ProjetLUDOMAT/Prototypes/README.md

# prototype

état du 2 décembre 2023 :
La voiture prototype sans contrôle optimal ni modèle inertiel 

https://github.com/ProjetLUDOMAT/prototype/assets/90700891/5bf04b09-5f97-4a13-8e84-bf554dca9c00
