ProjetLUDOMAT/Prototypes/Gilles/Proto 4/README.md

<p align="center">
  
<p/>
  
## Introduction

Quatrieme prototype, très proche de Proto 3. Mêmes moteurs et mêmes drivers. Le microcontrolleur est un RP2040 Zero, clone chinois du Raspberry Pico à 23 broches seulement (20 GPIOs). Deux LEDs blanches ont été ajoutées à l'avant pour indiquer le sens de déplacement. La diode neopixel du RP2040 Zero est utilisée pour indiquer le mode de fonctionnement. Un algorithme de détection de la télécommande a été ajouté.

## Schéma electrique

<p align="center">
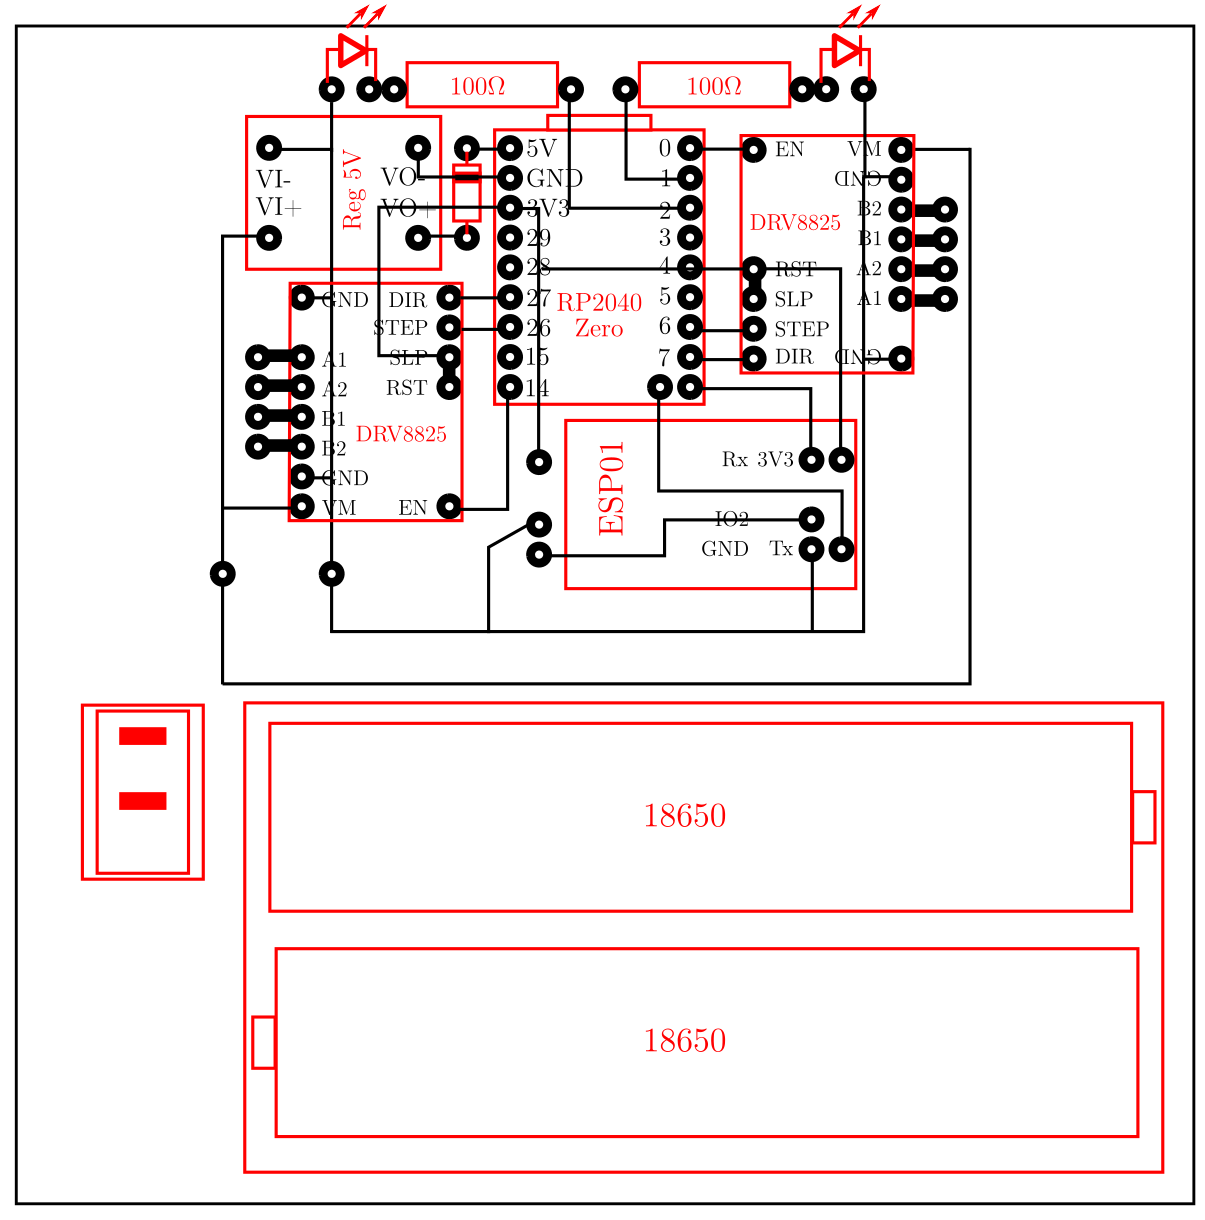
[picture p1: Gilles/Proto 4/implantation_composants_proto_4.png]

<p/>

## Liste de materiel:
- __RP2040 Zero__ : https://fr.aliexpress.com/item/1005005106663725.html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
- __driver moteur pas-a-pas DRV8825__ : https://fr.aliexpress.com/item/1005005264044268.html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
- __diode IR TL1838__ (ou équivalent): https://fr.aliexpress.com/item/4000610270256.html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
- __régulateur buck-boost DFR0569__ (ou équivalent): https://www.gotronic.fr/art-regulateur-5-vcc-dfr0569-29560.htm
- __ESP01__ : https://fr.aliexpress.com/item/1005004626018608.html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
- __telecommande IR__ : https://fr.aliexpress.com/item/1005005880586343.html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
- __3 accus Li-ion__ : https://fr.aliexpress.com/item/1005004551448757.html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
- __2 moteurs pas-a-pas bipolaires__ : https://www.gotronic.fr/art-moteur-24byj48-19028.htm
- __roue libre__ : [https://www.gotronic.fr/art-roue-libre-1-2-952-37787.htm](https://fr.aliexpress.com/item/1005005888599065.html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)https://fr.aliexpress.com/item/1005005888599065.html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
- __interrupteur miniature__ : https://fr.aliexpress.com/item/1005006245665830.html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

## Réalisation

Les composants sont implantés sur un circuit imprimé 100mmx100mm qui sert également de chassis (fichier _typon_proto_4.svg_). Les moteurs sont fixés au chassis à l'aide de 2 morceaux de cornière aluminium de 20mmx20mm. 

<p align="center">
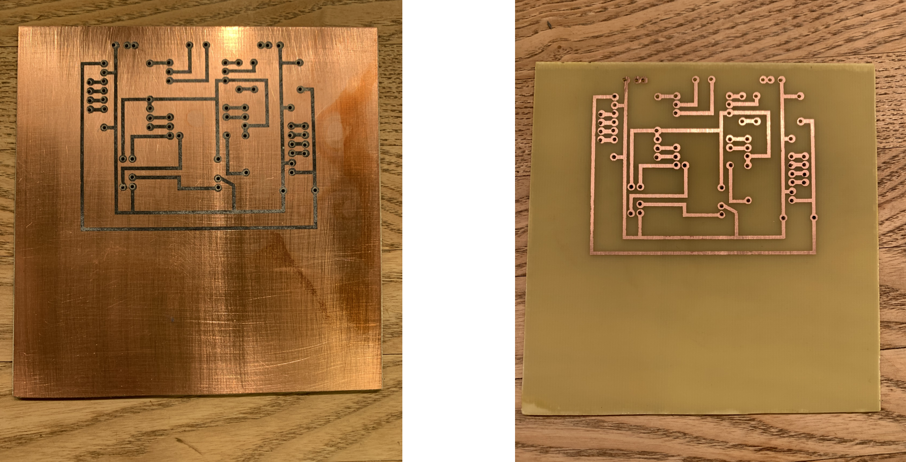
[picture p2: Gilles/Proto 4/pcb.png]
  
<p/>
  
Les roues sont fabriquées en impression 3D (fichier _roues.stl_). Les pneus sont faits en chambre à air de vélo (2 couches).

<p align="center">
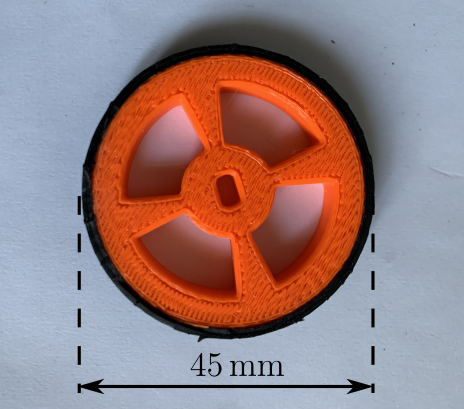
[picture p3: Gilles/Proto 4/roue.png]
  
<p/>
  
L'accu est fixé sur le chassis à l'aide de velcro autocollant afin de le rendre amovible.

Avant la mise sous tension, il faut régler la limite en courant de sortie des DRV8825 (300mA) : https://www.pololu.com/product/2133

## Fonctionnement

Après le boot, le robot attend l'association avec une télécommande : la diode neopixel est allumée en rouge. Pour l'associer, il suffit d'envoyer un code IR à partir d'une des télécommandes connues: Panasonic, Philips ou chinoise. La diode neopixel passe au vert et le robot est prêt à fonctionner.

<p align="center">
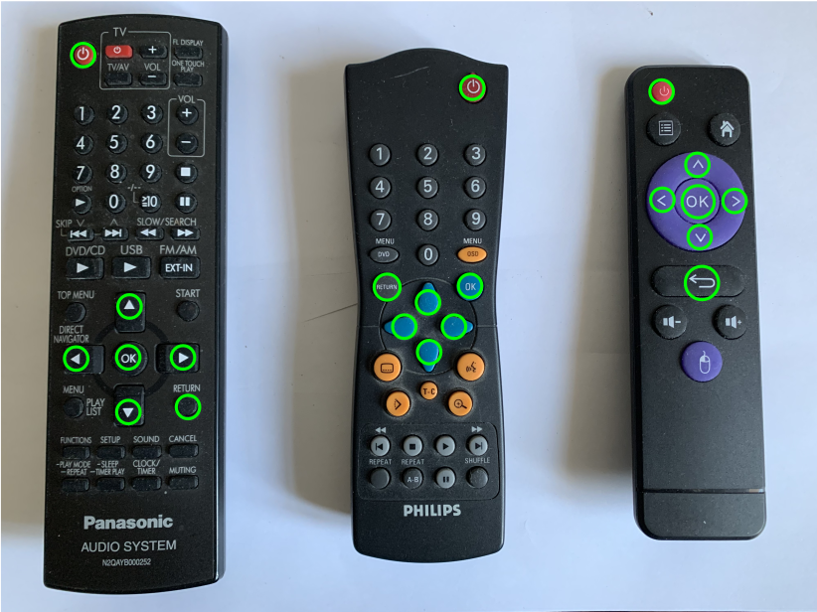
[picture p4: Gilles/Proto 4/telecommandes.png]
  
<p/>

__Attention__ : seules, les touches entourées en vert sur la photo sont reconnues : ON/OFF, GAUCHE, DROITE, HAUT, BAS, OK et RETURN.

Le robot possède deux modes de fonctionnement : 'RUN' et 'PROGRAMME'. La touche ON/OFF permet de switcher d'un mode à l'autre. En mode 'RUN', la diode neopixel est allumée en vert, en mode 'PROGRAMME', elle est allumée en bleu.

Au démarrage, le robot est en mode 'RUN' : le mouvement est exécuté 1 seconde après pression sur la touche de commande.

En mode 'PROGRAMME':

- les mouvements sont ajoutés séquentiellement dans le programme à chaque pression de touche, mais non executés,
- la touche OK provoque l'exécution du programme enregistré à partir du début. Les mouvements sont espacés de 1 seconde,
- la touche ON/OFF provoque la remise à zéro du programme et le passage en mode 'RUN',
- le passage en mode RUN efface la totalité du programme enregistré.

La touche RETURN termine l'execution du script. Il faut rebooter le RP2 (OFF/ON sur l'interrupteur) pour le relancer.
