ProjetLUDOMAT/Prototypes/Gilles/Proto 1/README.md

<p align="center">
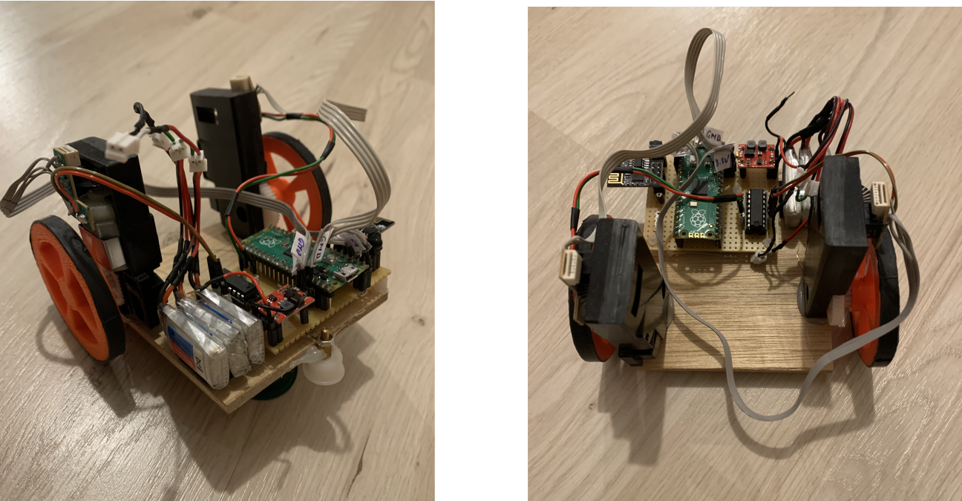
[picture p10: Gilles/Proto 1/photo_1.png]
  
<p/>

## Introduction

Ce premier prototype est basé sur un Raspberry Pico (_RP2_) programmé sous micropython.

Il utilise deux moteurs à courant continu munis chacun d'un encodeur optique et alimentés par un double pont en H (_L293D_). Le pilotage est fait par télécommande infra-rouge. Pour simplifier, la réception et la transmission des commandes au RP2 utilise une diode infra-rouge et un _ESP01_ programmé pour cette tâche.

L'alimentation des moteurs se fait en 12V (3 accus Li-ion). Un convertisseur buck-boost fournit les 5V nécessaires au RP2.

## Schéma electrique
<p align="center">
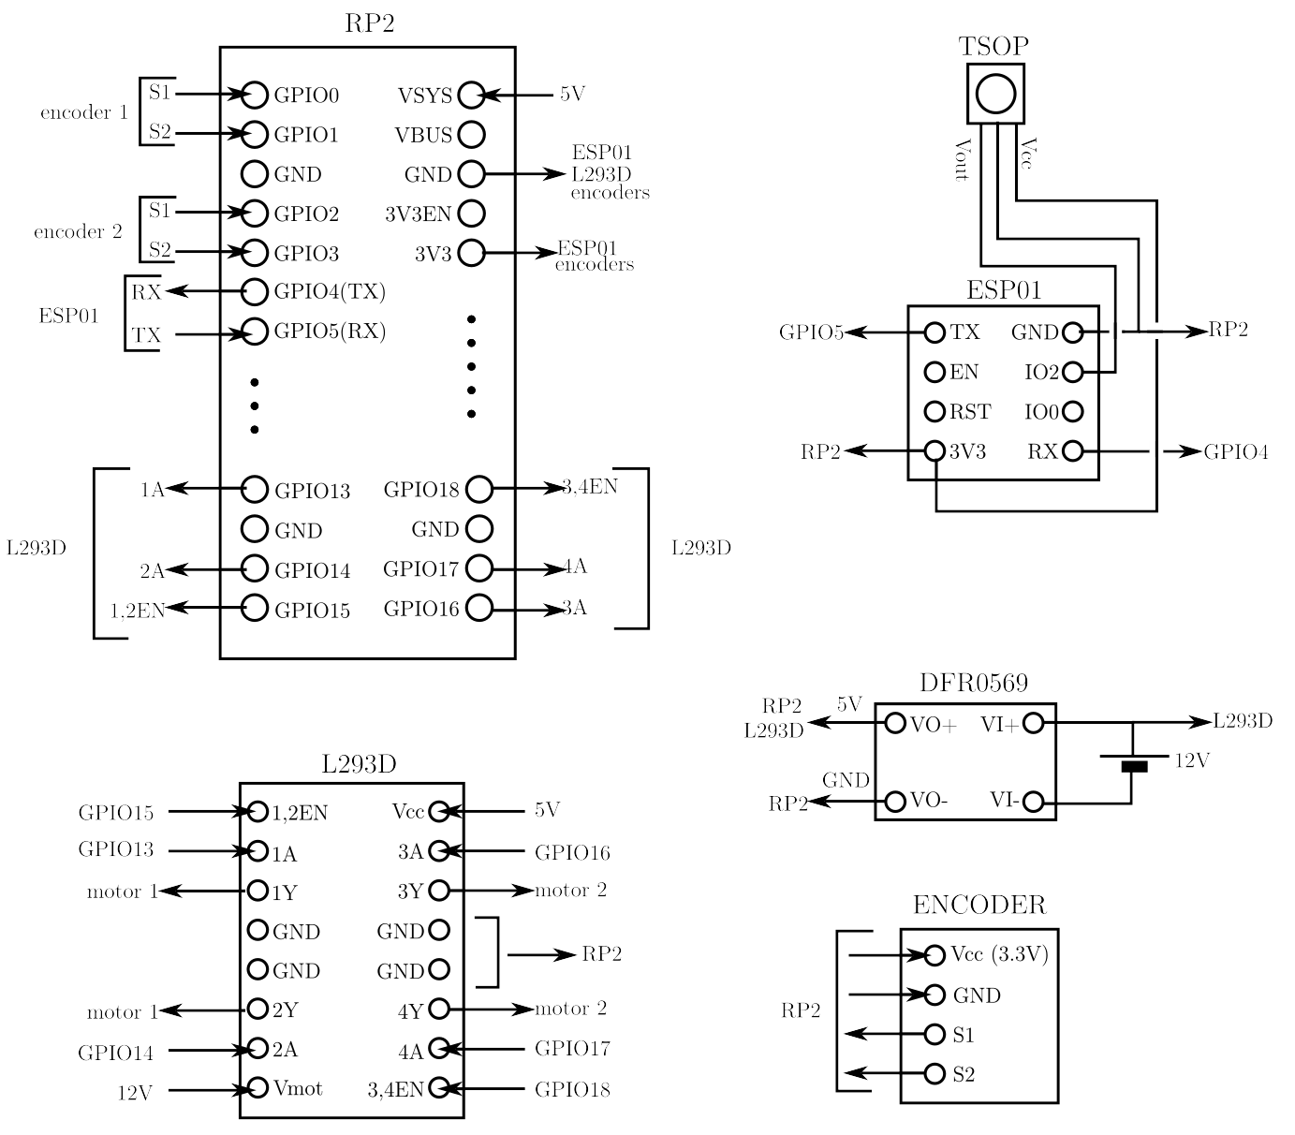
[picture p11: Gilles/Proto 1/Schema.png]
  
<p/>

## Liste de materiel:
- __Raspberry Pico__ : https://www.gotronic.fr/art-carte-raspberry-pi-pico-33027.htm
- __double pont en H L293D__ : https://www.gotronic.fr/art-l293d-14072.htm
- __diode IR TL1838__ (ou équivalent): https://fr.aliexpress.com/item/4000610270256.html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
- __régulateur buck-boost DFR0569__ (ou équivalent): https://www.gotronic.fr/art-regulateur-5-vcc-dfr0569-29560.htm
- __ESP01__ : https://fr.aliexpress.com/item/1005004626018608.html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
- __telecommande IR__ : https://fr.aliexpress.com/item/1005005880586343.html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
- __3 accus Li-ion__
- __2 moteurs à courant continu avec encodeurs__
- __roue libre__ : https://www.gotronic.fr/art-roue-libre-1-2-952-37787.htm

## Réalisation

<p align="center">
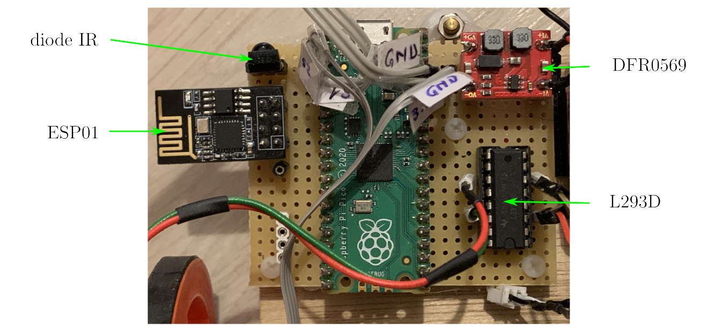
[picture p12: Gilles/Proto 1/photo_3.png]
  
<p/>

Le chassis est en contreplaqué d'épaisseur 5mm.

Les moteurs de ce prototype sont des moteurs récupérés sur l'entrainement scanner d'une imprimante jet d'encre. Ils ont l'avantage d'être munis d'encodeurs à signaux en quadrature permettant de déterminer la position, la vitesse et le sens de rotation de chacune des roues. 

<p align="center">
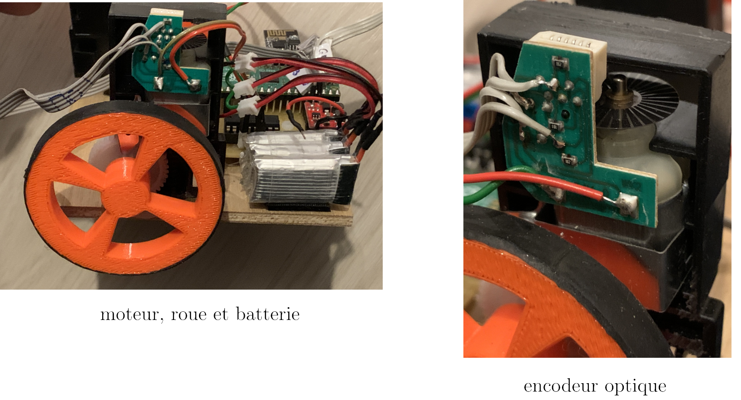
[picture p13: Gilles/Proto 1/photo_2.png]
  
<p/>

Les roues, de diamètre 60mm, ont été fabriquées en impression 3D. Compte-tenu de la réduction (engrenages plastiques), chaque encodeur fournit 1450 pulses par tour, ce qui donne une précision très satisfaisante sur la position (et la vitesse).

## Installation

Avec l'IDE Arduino, téléverser le fichier _IRrecvDemo.ino_ dans l'_ESP01_. Ce dernier est alors programmé pour recevoir en continu les signaux de la télécommande et les transmettre au _RP2_ sur la liaison série UART1. La vitesse de transmission est fixée à 9600 bauds, mais elle peut être augmentée à 115200 bauds sans difficulté. Par défaut, le codage IR utilisé est celui de la télécommande ci-dessus ("chinoise"). Il est possible d'utiliser un autre modèle à condition de remplacer le fichier _codes_chi.py_ par un fichier contenant les nouveaux codes. Ci-dessus, _codes_pan.py_ = Panasonic, _codes_phi.py_ = Philips, _codes_sam.py_ = samsung.

Charger ensuite l'interpreteur micropython sur la carte RP2, puis copier les fichiers .py ci-dessus dans le répertoire principal. A la mise sous tension le robot est prêt à fonctionner.

## Fonctionnement

<p align="center">
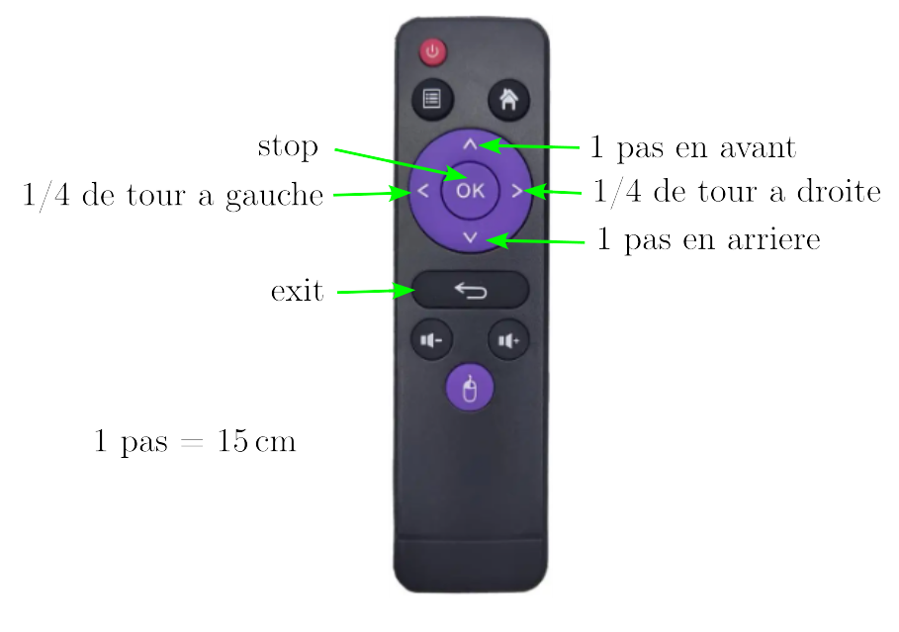
[picture p14: Gilles/Proto 1/telecommande.png]
  
<p/>

## Code

- __dcMotor.py__ : driver de moteur à courant continu.
- __PioEncoder.py__ : driver d'encodeur optique. Il est basé sur les machines d'état (Pio) du RP2.
- __codes_chi.py__ : codes infra-rouges de la télécommande (avec la fonction de lecture _decode_ir_).
- __proto_ludomat_1.py__ : script principal
  
  la fonction _go_position_ qui permet d'atteindre la position cible contient un correcteur PD (proportionnelle-dérivée) pour chacun des moteurs. L'arrêt du moteur se fait à l'interieur d'un intervalle centré sur la position cible (_tgt_count_) de largeur _dead_zone_=3. L'erreur de position linéaire est donc au maximum de : 3/1450 x pi x 60 = 0,4 mm pour chacune des roues.
