ProjetLUDOMAT/Prototypes/Motor driver L9110S/image01.png

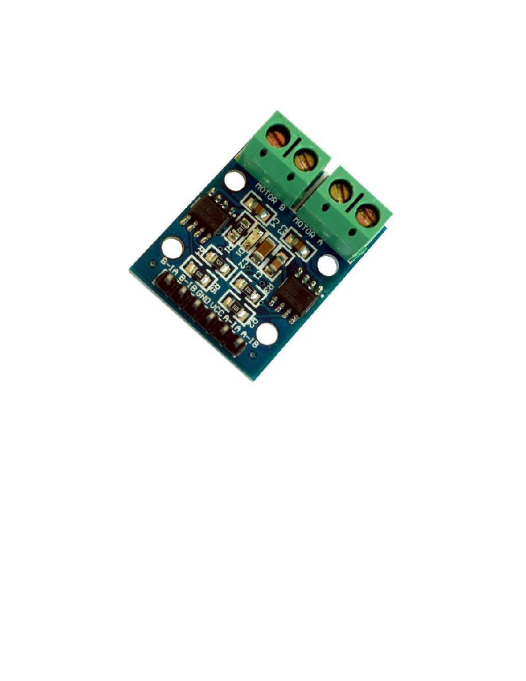
Motor driver L9110S/image01.png
