ProjetLUDOMAT/Prototypes/photo_1.png

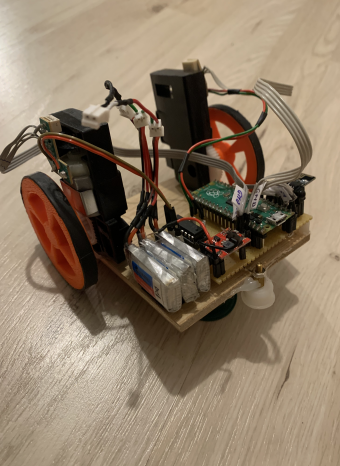
photo_1.png
