ProjetLUDOMAT/Prototypes/Gilles/Proto 4/roue.STL

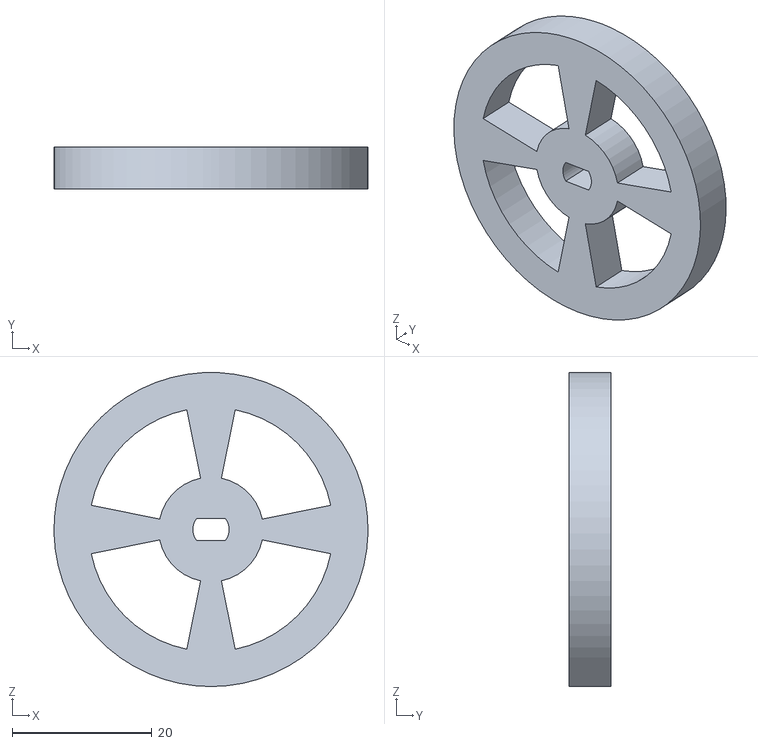
[picture p21: CAD file, 2024-01-19]
Gilles/Proto 4/roue.STL
45.0 x 6.00 x 45.0
