ProjetLUDOMAT/Prototypes/(commit log)

2023-12-03 Structuration des dossiers du projet
2023-12-07 CAO KiCad pour le premier prototype
    [prototype_1.kicad_pcb, prototype_1.kicad_sch]
2023-12-12 Mise à jour pour le schéma
    [prototype_1.kicad_sch]
2024-01-31 Add files via upload
    Ajout de la nomenclature des composants
